tactical-snacks/hum_hw/production/board_spec.txt

BOARD SPEC
Project:   
Revision:  

GENERAL
  Layers:          
  Material:        FR-4, Tg 150
  Board size:      W x H mm
  Thickness:       1.6 mm +/-10% (1.44-1.76 mm)

STACKUP
  L1               0.5 oz + plating (~1 oz / 35 um finished)
  Prepreg          0.20 mm
  L2               1 oz (35 um)
  Core             1.03 mm
  L3               1 oz (35 um)
  Prepreg          0.20 mm
  L4               0.5 oz + plating (~1 oz / 35 um finished)
  Total            1.57 mm nominal

FINISH
  Surface finish:  ENIG
  Soldermask:      Green, both sides
  Silkscreen:      White, both sides
  Via treatment:   Tented, except vias in exposed pads (U2, U3)

ELECTRICAL
  Impedance:       Not required

ASSEMBLY
