tactical-snacks/hum_hw/images/hum_hw__bott.png

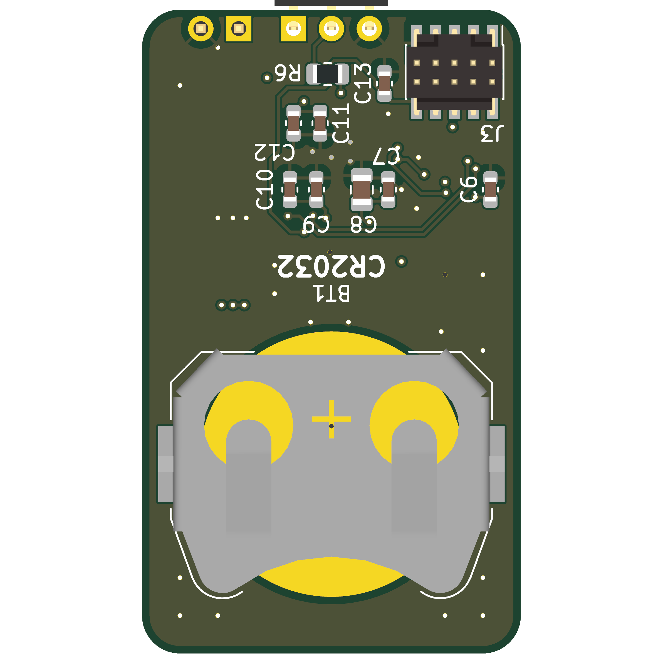
images/hum_hw__bott.png
