tactical-snacks/hum_hw/images/hum_hw__topp.png

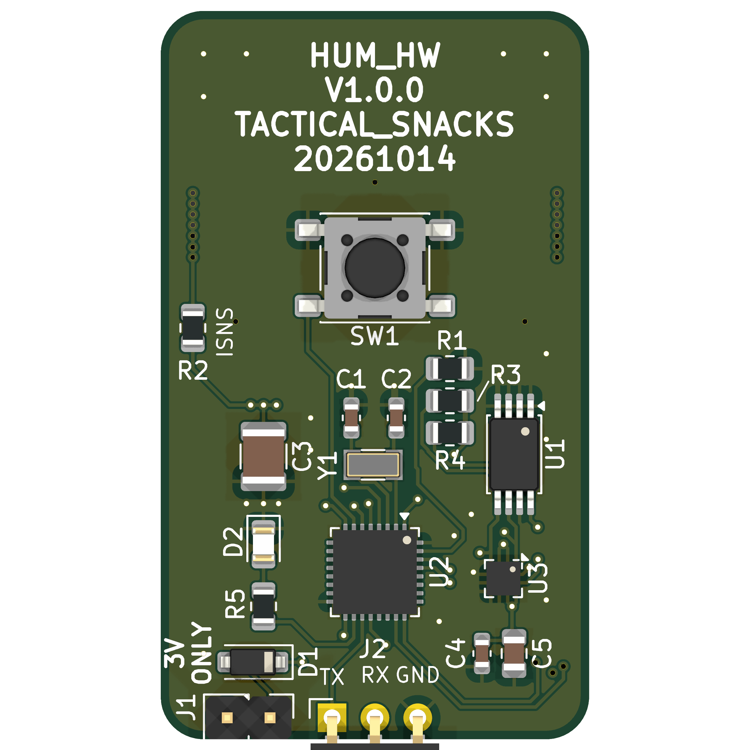
images/hum_hw__topp.png
