tactical-snacks/hum_hw/production/bom.csv

Designator | Footprint | Quantity | Value | LCSC Part #
BT1 | BatteryHolder_Keystone_3034_1x20mm | 1 | Battery_Cell
C1, C2 | 0603 | 2 | 6.8pF C0G/NP0
C10 | 0603 | 1 | 10nF 10V X7R
C11, C13, C4, C6, C7 | 0603 | 5 | 100nF 10V X7R
C12 | 0603 | 1 | 4.7uF 10V X7R
C3 | 1210 | 1 | 47uF 10V X7R
C5 | 0805 | 1 | 10uF 10V X7R
C8 | 0805 | 1 | 4.7uF 10V X7R
C9 | 0603 | 1 | 1uF 10V X7R
D1 | D_SOD-123 | 1 | 1N4148W
D2 | 0805 | 1 | LED
J1 | PinHeader_1x02_P2.54mm_Vertical | 1 | Conn_01x02_Pin
J2 | PinSocket_1x03_P2.54mm_Horizontal | 1 | Conn_01x03
J3 | PinHeader_2x05_P1.27mm_Vertical_SMD | 1 | Conn_ARM_JTAG_SWD_10
R1 | 0805 | 1 | 10k
R2 | 0805 | 1 | 0R
R3, R4, R5 | 0805 | 3 | 4.7k
R6 | 0805 | 1 | 1k
SW1 | SW_SPST_PTS645Sx43SMTR92 | 1 | SW_SPST
U1 | TSSOP-8_4.4x3mm_P0.65mm | 1 | 24FC512-I/ST
U2 | QFN-32-1EP_5x5mm_P0.5mm_EP3.45x3.45mm | 1 | STM32U031K8U6
U3 | LGA-12_2x2mm_P0.5mm | 1 | LIS2DTW12TR
Y1 | Crystal_SMD_3215-2Pin_3.2x1.5mm | 1 | 32.768kHZ
