tactical-snacks/hum_hw/3D/hum_hw.step

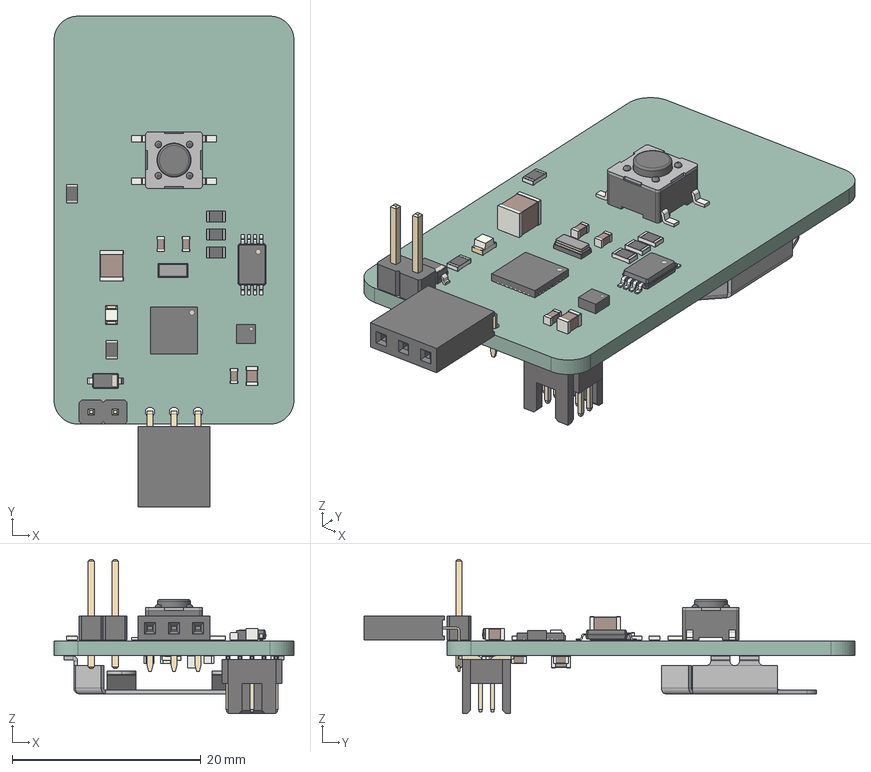
[picture p3: CAD file, 2026-10-19]
3D/hum_hw.step
25.4 x 51.9 x 16.3 mm
LGA_12_2x2mm_P05mm
C_0603_1608Metric x 10
R_0805_2012Metric x 6
C_1210_3225Metric
TSSOP-8_4.4x3mm_P0.65mm
PinSocket_1x03_P2.54mm_Horizontal
LED_0805_2012Metric
PinHeader_1x02_P254mm_Vertical
D_SOD-123
SW_SPST_PTS645Sx43SMTR92
C_0805_2012Metric x 2
Crystal_SMD_3215-2Pin_3.2x1.5mm
QFN-32-1EP_5x5mm_Pitch0.5mm
BatteryHolder_Keystone_3034_1x20mm
BD125-10-A-0305-0580-L-B_H
BD125-10-A-0305-0580-L-B_P x 10
hum_hw_PCB
