tactical-snacks/hum_hw/hum_hw.pdf

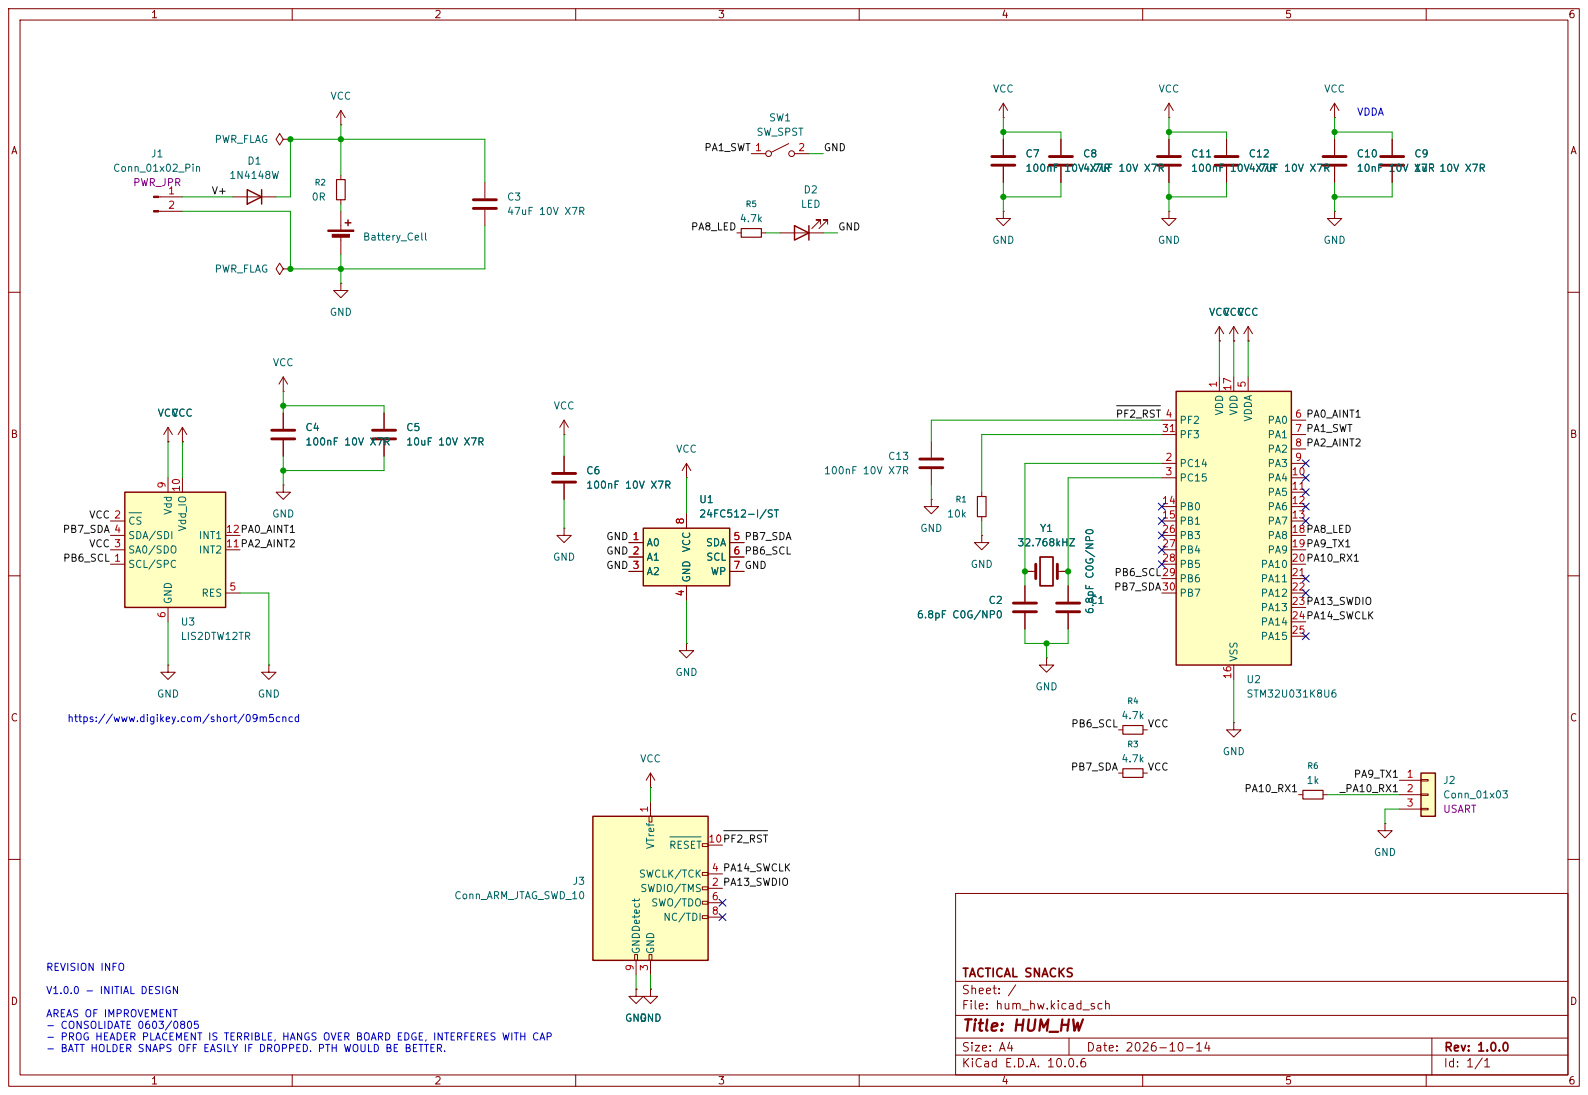
[picture p4: page 1]

https://www.digikey.com/short/09m5cncd

AREAS OF IMPROVEMENT - CONSOLIDATE 0603/0805 - PROG HEADER PLACEMENT IS TERRIBLE, HANGS OVER BOARD EDGE, INTERFERES WITH CAP - BATT HOLDER SNAPS OFF EASILY IF DROPPED. PTH WOULD BE BETTER.

Size: A4 | Rev: 1.0.0
KiCad E.D.A. 10.0.6 | Id: 1/1
