tactical-snacks/hum_hw/hum_hw.kicad_pcb

## KiCad design hum_hw.kicad_pcb (2026-10-19)

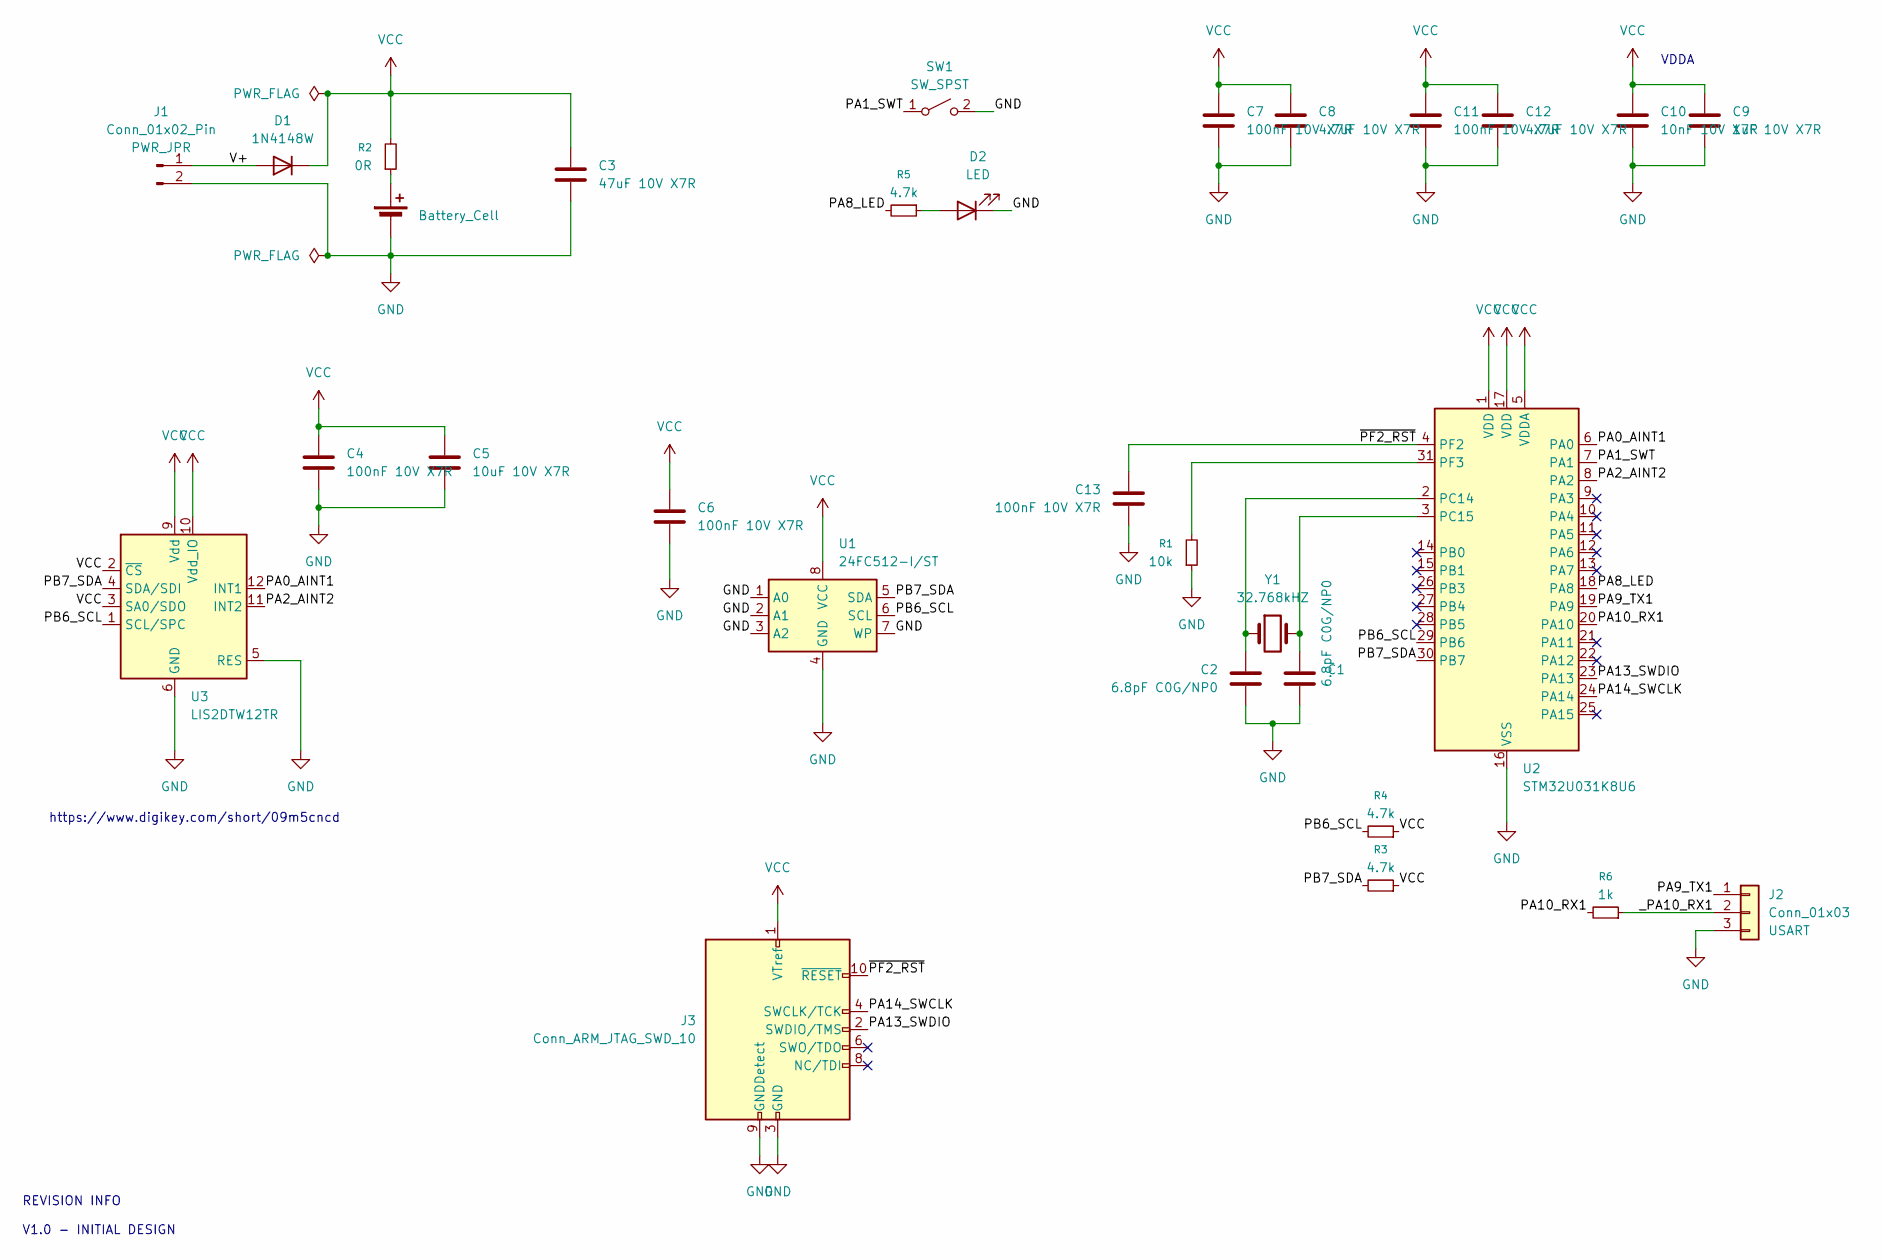
[picture p5: schematic hum_hw.kicad_sch, TITLE]

Parts:
BT1: Battery_Cell; BatteryHolder_Keystone_3034_1x20mm; MFR_PN 3034
C1, C2: 6.8pF C0G/NP0; C_0603_1608Metric
C3: 47uF 10V X7R; C_1210_3225Metric
C4, C6, C7, C11, C13: 100nF 10V X7R; C_0603_1608Metric
C5: 10uF 10V X7R; C_0805_2012Metric
C8: 4.7uF 10V X7R; C_0805_2012Metric
C9: 1uF 10V X7R; C_0603_1608Metric
C10: 10nF 10V X7R; C_0603_1608Metric
C12: 4.7uF 10V X7R; C_0603_1608Metric
D1: 1N4148W; D_SOD-123
D2: LED; LED_0805_2012Metric; MFR_PN LTST-C170TGKT
J1: Conn_01x02_Pin; PinHeader_1x02_P2.54mm_Vertical
J2: Conn_01x03; PinSocket_1x03_P2.54mm_Horizontal
J3: Conn_ARM_JTAG_SWD_10; PinHeader_2x05_P1.27mm_Vertical_SMD; MFR_PN BD125-10-A-0305-0580-L-B
R1: 10k; R_0805_2012Metric
R2: 0R; R_0805_2012Metric
R3, R4, R5: 4.7k; R_0805_2012Metric
R6: 1k; R_0805_2012Metric
SW1: SW_SPST; SW_SPST_PTS645Sx43SMTR92
U1: 24FC512-I/ST; TSSOP-8_4.4x3mm_P0.65mm; MFR_PN 24FC512-I/ST
U2: STM32U031K8U6; QFN-32-1EP_5x5mm_P0.5mm_EP3.45x3.45mm
U3: LIS2DTW12TR; LGA-12_2x2mm_P0.5mm; MFR_PN LIS2DTW12TR
Y1: 32.768kHZ; Crystal_SMD_3215-2Pin_3.2x1.5mm; MFR_PN ABS07-120-32.768KHZ-T

Connections:
/PA0_AINT1: U2.6 (PA0), U3.12 (INT1)
/PA1_SWT: SW1.1 (A), U2.7 (PA1)
/PA2_AINT2: U2.8 (PA2), U3.11 (INT2)
/PA8_LED: R5.2, U2.18 (PA8)
/PA9_TX1: J2.1, U2.19 (PA9)
/PA10_RX1: R6.2, U2.20 (PA10)
/PA13_SWDIO: J3.2 (SWDIO/TMS), U2.23 (PA13)
/PA14_SWCLK: J3.4 (SWCLK/TCK), U2.24 (PA14)
/PB6_SCL: R4.2, U1.6 (SCL), U2.29 (PB6), U3.1 (SCL/SPC)
/PB7_SDA: R3.2, U1.5 (SDA), U2.30 (PB7), U3.4 (SDA/SDI)
/V+: D1.2 (A), J1.1
/_PA10_RX1: J2.2, R6.1
/~PF2_RST: C13.1, J3.10 (~RESET), U2.4 (PF2)
GND: BT1.2 (-), C1.2, C2.2, C3.2, C4.2, C5.2, C6.2, C7.2, C8.2, C9.2, C10.2, C11.2, C12.2, C13.2, D2.1 (K), J1.2, J2.3, J3.3 (GND), J3.5 (GND), J3.9 (GNDDetect), R1.1, SW1.2 (B), U1.1 (A0), U1.2 (A1), U1.3 (A2), U1.4 (GND), U1.7 (WP), U2.16 (VSS), U2.32 (VSS), U2.33 (VSS), U3.5 (RES), U3.6 (GND), U3.7 (GND), U3.8 (GND)
unnamed: BT1.1 (+), R2.1
unnamed: D2.2 (A), R5.1
unnamed: C2.1, U2.2 (PC14), Y1.1
unnamed: C1.1, U2.3 (PC15), Y1.2
unnamed: R1.2, U2.31 (PF3)
VCC: C3.1, C4.1, C5.1, C6.1, C7.1, C8.1, C9.1, C10.1, C11.1, C12.1, D1.1 (K), J3.1 (VTref), R2.2, R3.1, R4.1, U1.8 (VCC), U2.1 (VDD), U2.5 (VDDA), U2.17 (VDD), U3.2 (~CS), U3.3 (SA0/SDO), U3.9 (Vdd), U3.10 (Vdd_IO)

Notes on the sheet:
VDDA
REVISION INFO V1.0 - INITIAL DESIGN
https://www.digikey.com/short/09m5cncd

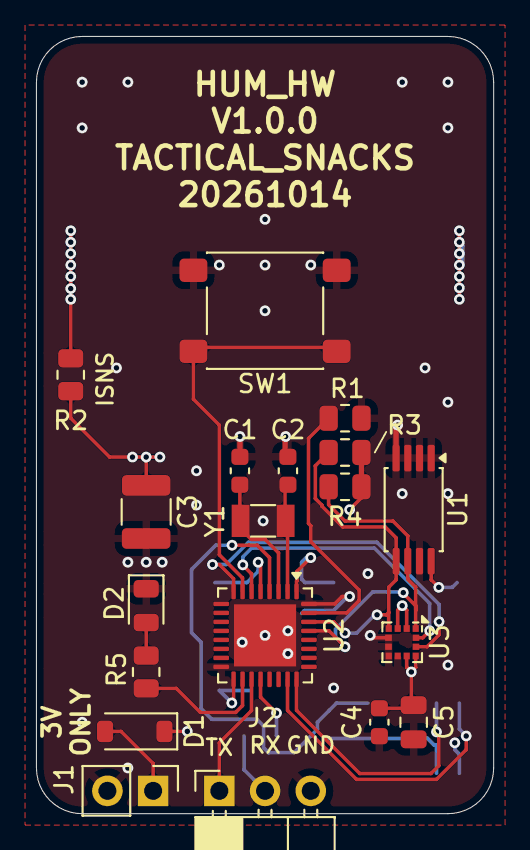
[picture p6: board hum_hw.kicad_pcb from above]

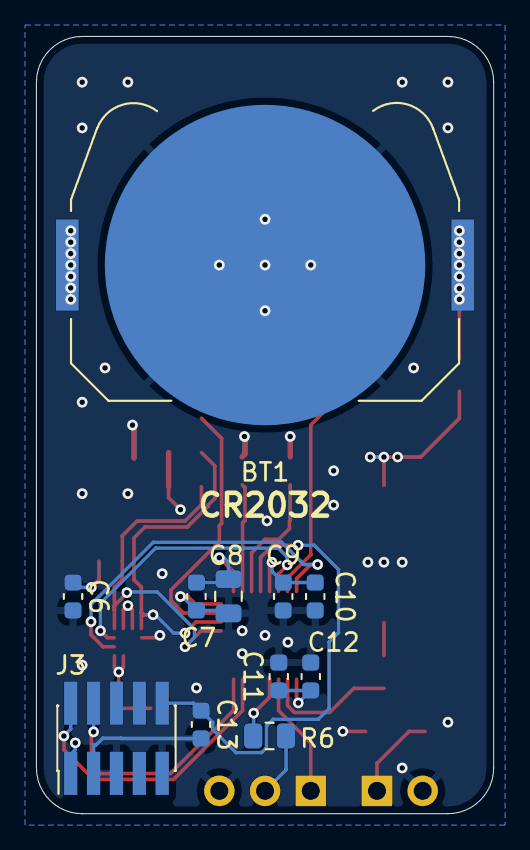
[picture p7: board hum_hw.kicad_pcb from below]

Board: 4 copper layers, 25.4 x 43.2 mm, 30 parts (11 on the bottom side), 20 nets.
