tactical-snacks/hum_hw/(commit log)

2026-10-12 readme, power budget
2026-10-14 brd layout
    [hum_hw.kicad_pcb, hum_hw.kicad_sch]
2026-10-15 brd layout complete
    [bom.csv, designators.csv, hum_hw.kicad_pcb, hum_hw.kicad_sch, positions.csv]
2026-10-19 stp, renders, datasheets
    [hum_hw.kicad_pcb, hum_hw.kicad_sch, hum_hw.step]
2026-10-19 rot bat for kicad
2026-10-30 pics, areas of improvement
    [hum_hw.kicad_sch]
2026-10-30 title block, pdf
    [hum_hw.kicad_sch]
